ymfpfp/flamingo/manufacturing/stackup/calculator-85ohm.png

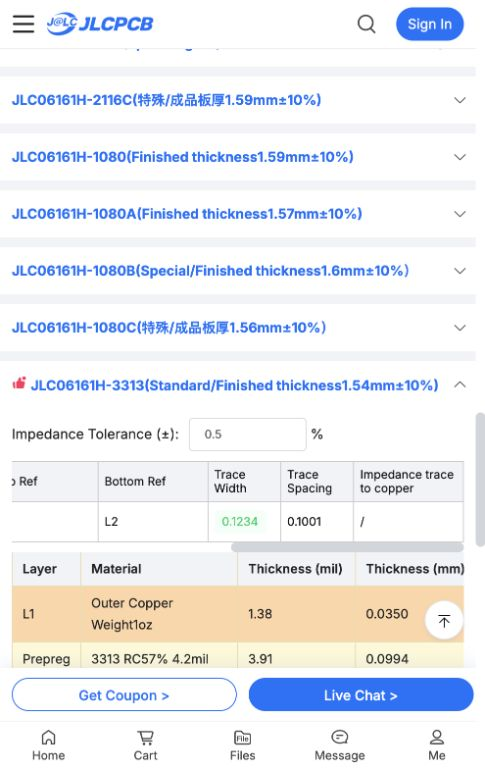
manufacturing/stackup/calculator-85ohm.png
