ymfpfp/flamingo/assets/artwork/ts-mark-source.png

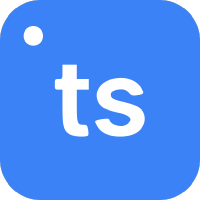
assets/artwork/ts-mark-source.png
