ymfpfp/flamingo/(list of files, drawings)

Other design files:
datasheets/research/slot-mosfet-startup-2026-10-22/Si4497DY-Si4497DY_PS.olb
datasheets/research/slot-mosfet-startup-2026-10-22/Si4497DY-SI4497DY_PS_RC.OLB
datasheets/research/vdd-loadstep-2026-10-27/model/TPS62816-Q1_PSPICE_TRANS/TPS62816-Q1_TRANS.DSN
datasheets/research/vdd-loadstep-2026-10-27/model/TPS62816-Q1_PSPICE_TRANS/TPS62816-Q1_TRANS.OPJ
datasheets/research/vdd-loadstep-2026-10-27/model/TPS62816-Q1_PSPICE_TRANS/TPS62816-Q1RWY_TRANS.OLB
