ymfpfp/flamingo/manufacturing/stackup/calculator-85ohm-result.png

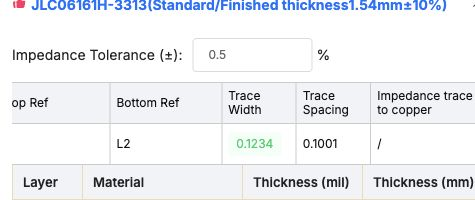
manufacturing/stackup/calculator-85ohm-result.png
