ymfpfp/flamingo/(commit log)

2026-10-14 spi and uart
2026-10-15 usb for schematic
2026-10-15 psu led indicator
2026-10-15 buck converters
2026-10-16 decaps for all rails
2026-10-18 finalize schematic rev
2026-10-20 power routing
